Stup702/3d-pos-mashin/case_bottom_b123d.step

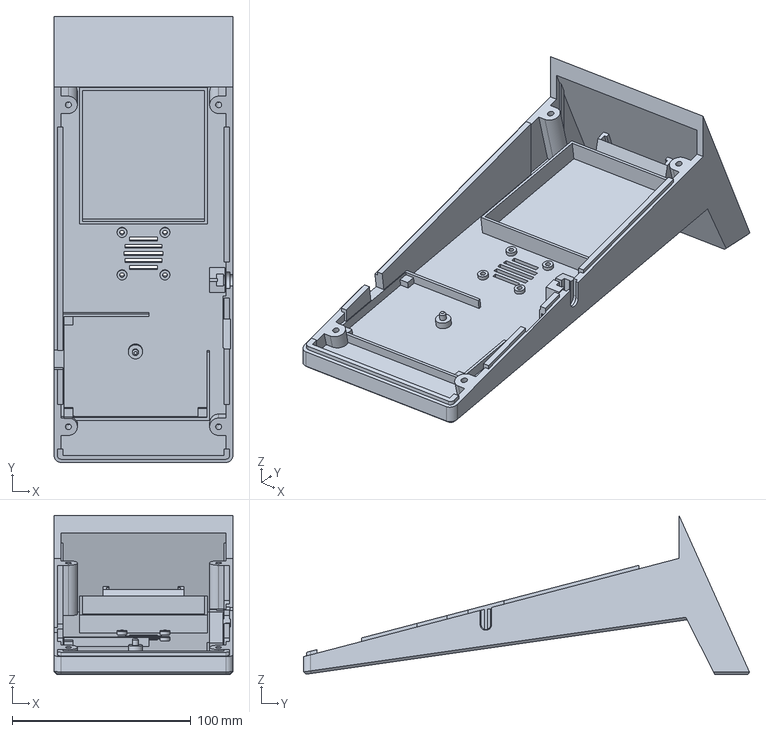
[picture p1: CAD file, 2026-09-17]
case_bottom_b123d.step
100.0 x 249.4 x 89.0 mm
