Stup702/3d-pos-mashin/case_top.step

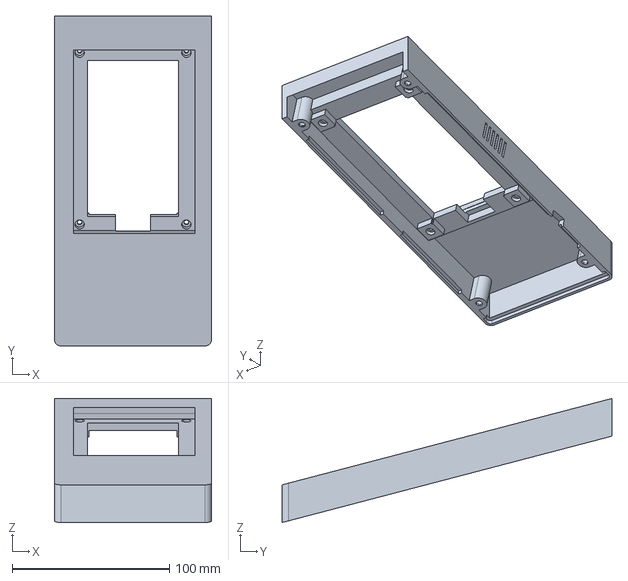
[picture p2: CAD file, 2026-09-17]
case_top.step
100.0 x 210.0 x 79.0 mm
