Stup702/3d-pos-mashin/test_button_plunger.step

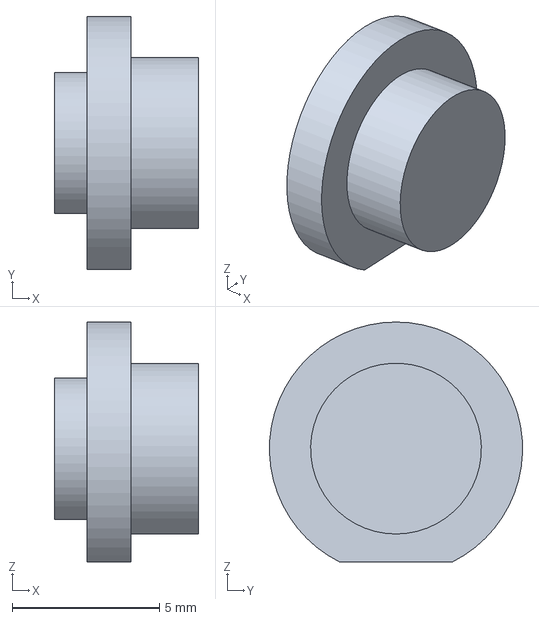
[picture p3: CAD file, 2026-09-17]
test_button_plunger.step
4.90 x 8.59 x 8.15 mm
