Stup702/3d-pos-mashin/test_plate_nfc.step

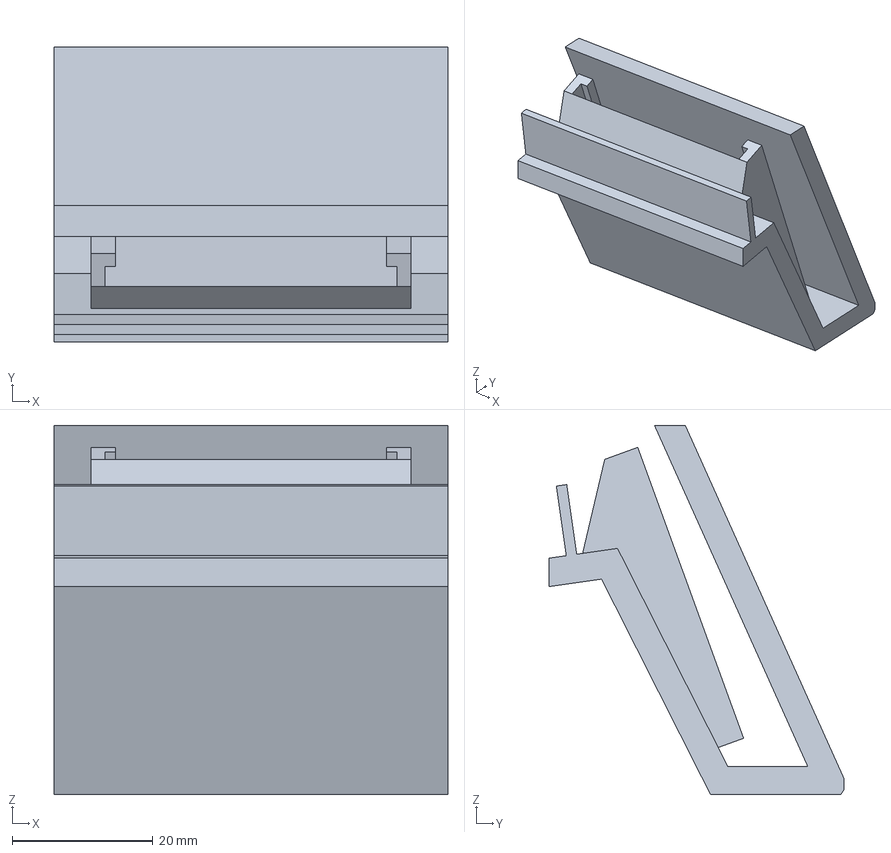
[picture p4: CAD file, 2026-09-17]
test_plate_nfc.step
56.0 x 42.0 x 52.5 mm
