Stup702/3d-pos-mashin/button_keystone.step

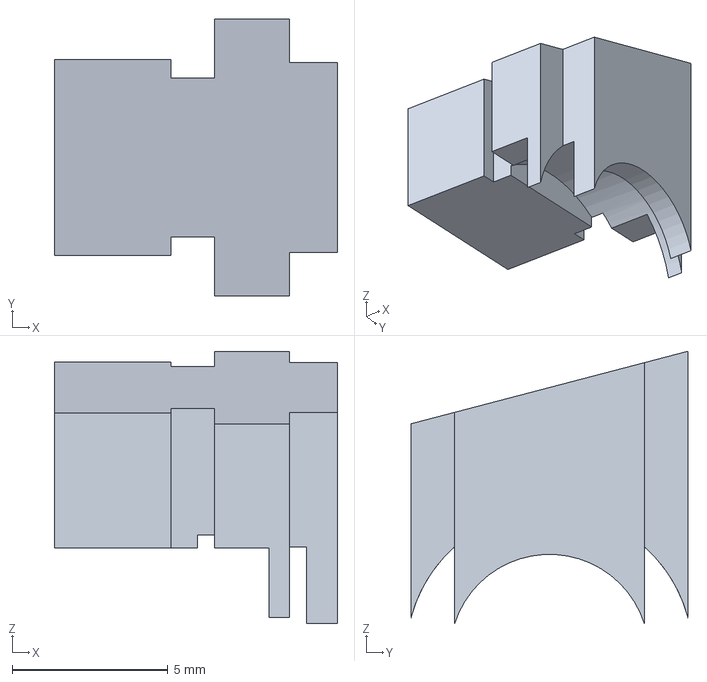
[picture p5: CAD file, 2026-09-17]
button_keystone.step
9.10 x 8.90 x 8.76 mm
