Stup702/3d-pos-mashin/test_plate_acer_vent.step

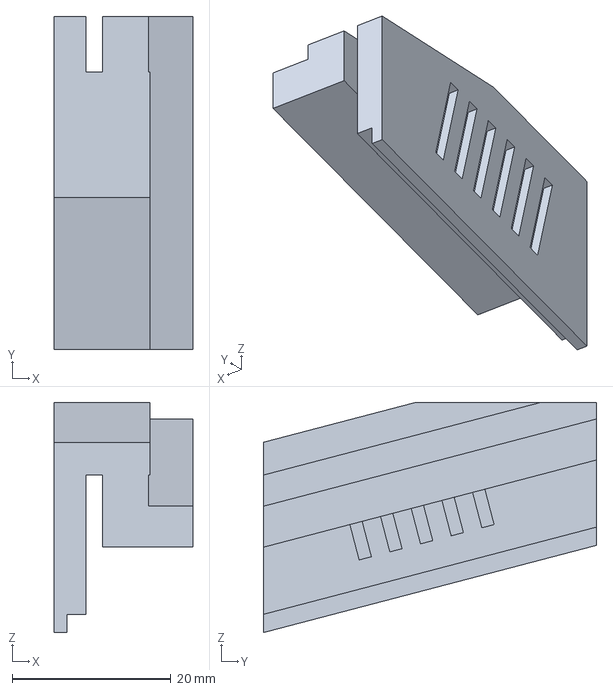
[picture p6: CAD file, 2026-09-17]
test_plate_acer_vent.step
17.5 x 42.0 x 29.0 mm
