Stup702/3d-pos-mashin/test_plate_battery_indicator.step

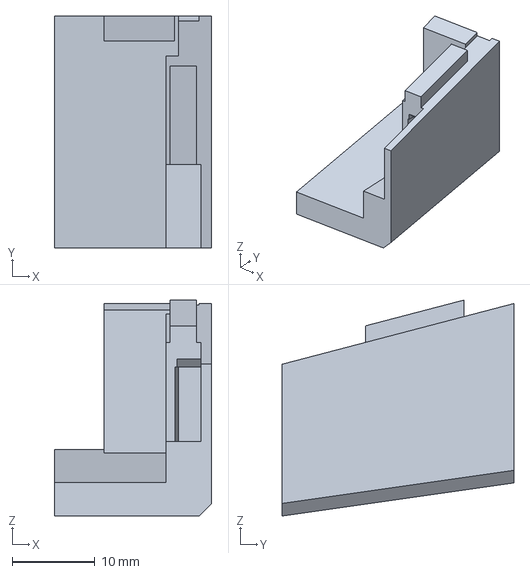
[picture p7: CAD file, 2026-09-17]
test_plate_battery_indicator.step
19.0 x 28.0 x 26.1 mm
