Stup702/3d-pos-mashin/test_plate_heat_insert.step

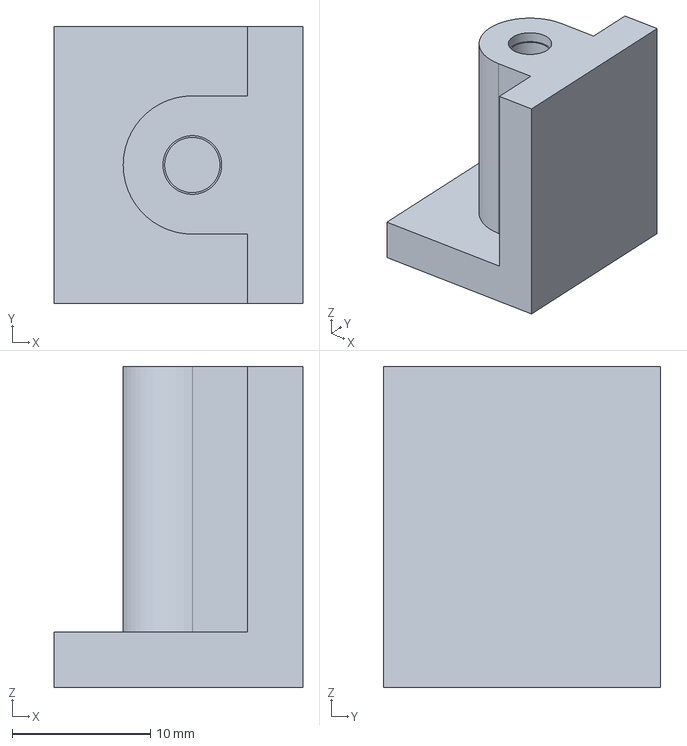
[picture p8: CAD file, 2026-09-17]
test_plate_heat_insert.step
18.0 x 20.0 x 23.2 mm
