Stup702/3d-pos-mashin/test_plate_ups.stl

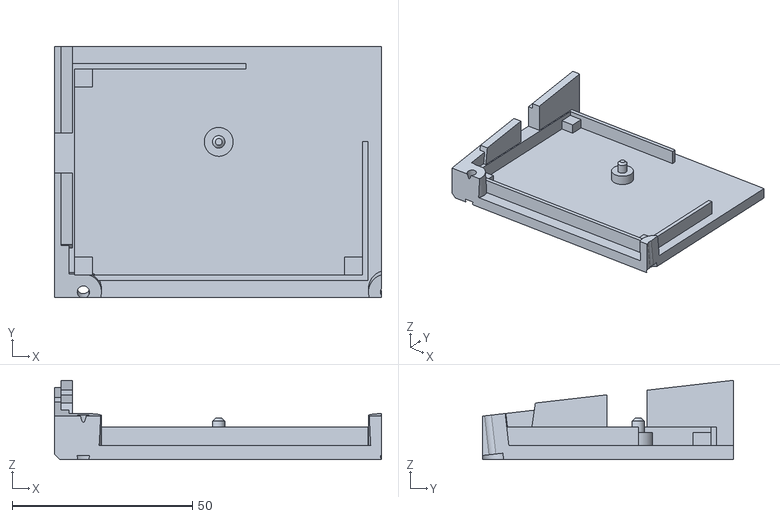
[picture p9: CAD file, 2026-09-16]
test_plate_ups.stl
90.6 x 69.5 x 22.0
