Stup702/3d-pos-mashin/test_plate_screen.stl

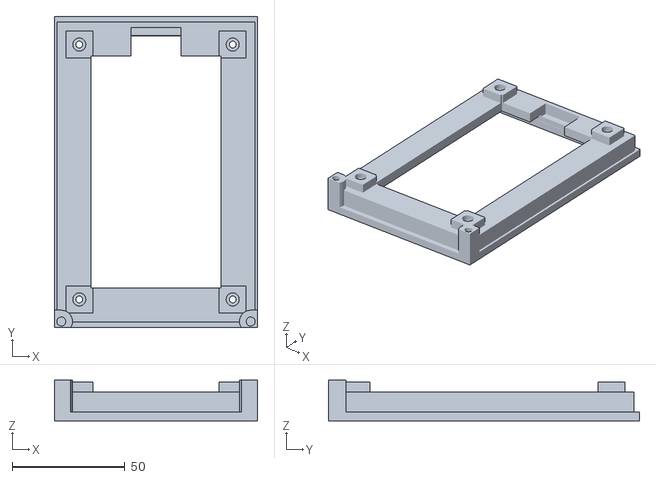
[picture p10: CAD file, 2026-09-16]
test_plate_screen.stl
90.0 x 138.0 x 18.0
