Stup702/3d-pos-mashin/test_plate_battery.stl

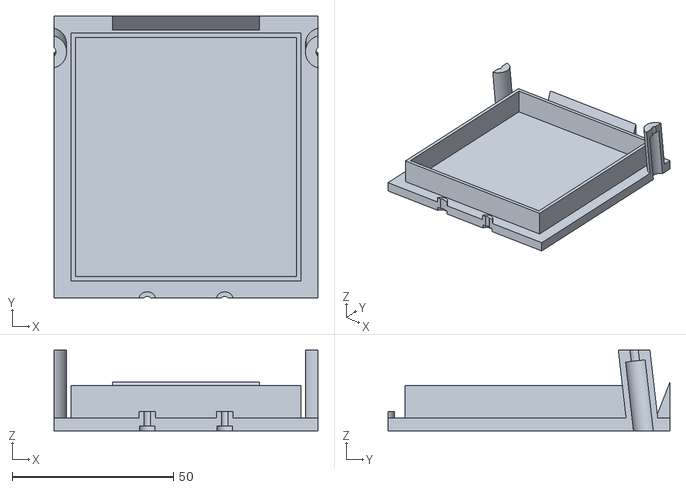
[picture p11: CAD file, 2026-09-16]
test_plate_battery.stl
81.8 x 87.3 x 25.0
