Stup702/3d-pos-mashin/test_plate_fan.stl

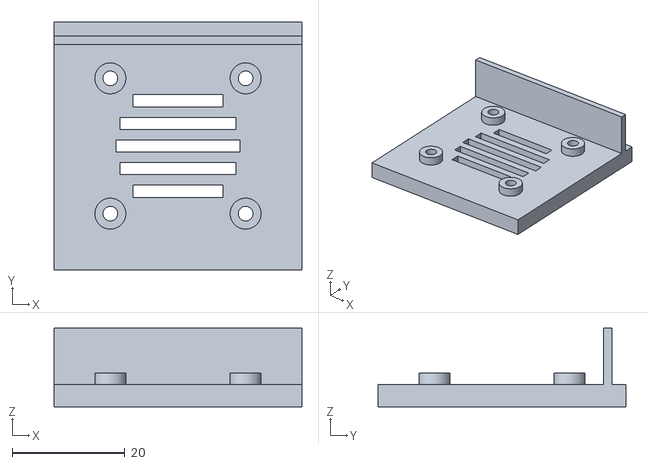
[picture p12: CAD file, 2026-09-16]
test_plate_fan.stl
44.0 x 44.0 x 14.0
