Stup702/3d-pos-mashin/test_plate_button.step

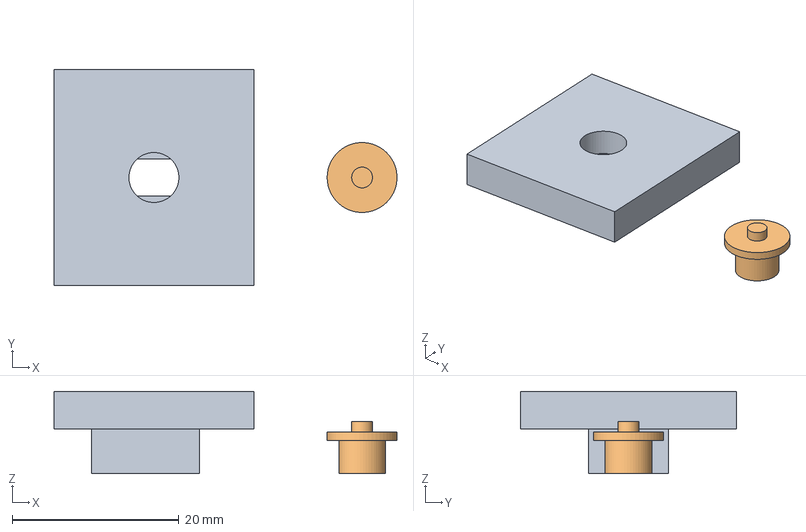
[picture p13: CAD file, 2026-09-15]
test_plate_button.step
41.2 x 26.0 x 9.90 mm
