Stup702/3d-pos-mashin/test_plate_underbelly.step

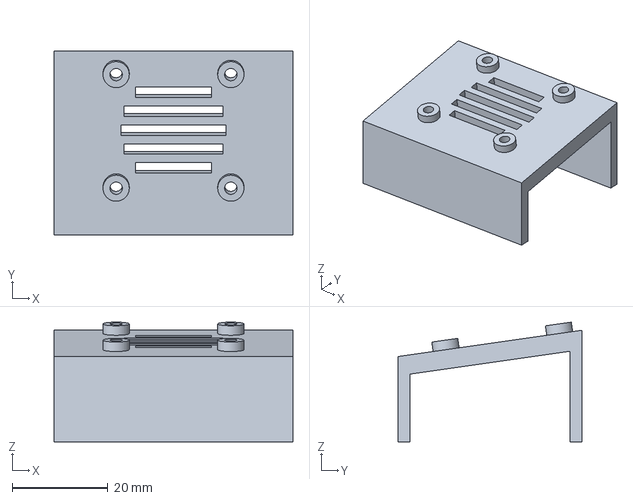
[picture p14: CAD file, 2026-09-15]
test_plate_underbelly.step
50.0 x 38.5 x 25.1 mm
