Stup702/3d-pos-mashin/ups_dummy.stl

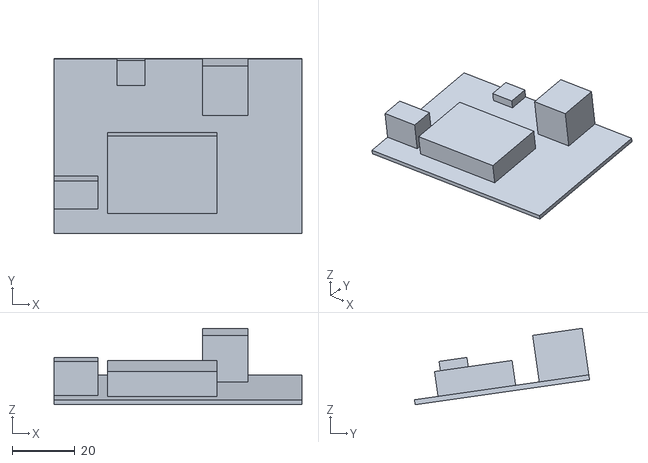
[picture p15: CAD file, 2026-09-07]
ups_dummy.stl
79.1 x 55.9 x 24.4
