Stup702/3d-pos-mashin/screen_dfr0550.stl

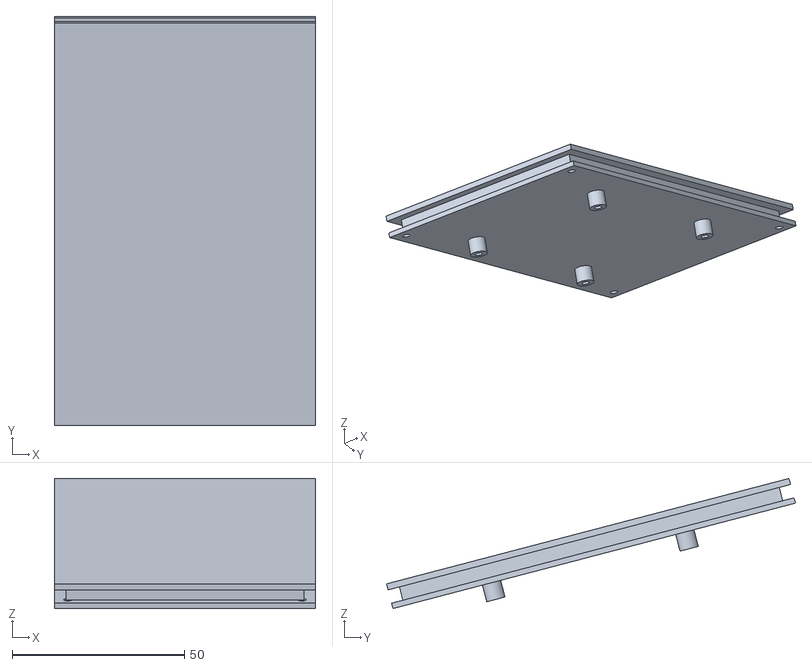
[picture p16: CAD file, 2026-09-07]
screen_dfr0550.stl
75.8 x 118.7 x 37.8
