Stup702/3d-pos-mashin/fan_dummy.stl

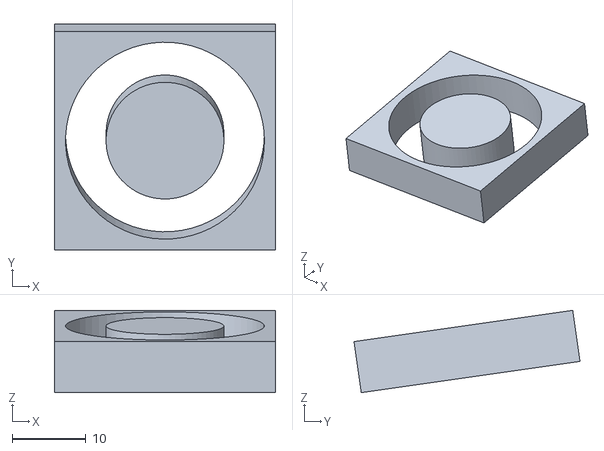
[picture p17: CAD file, 2026-09-07]
fan_dummy.stl
30.0 x 30.7 x 11.2
