Stup702/3d-pos-mashin/rpi4_b.stl

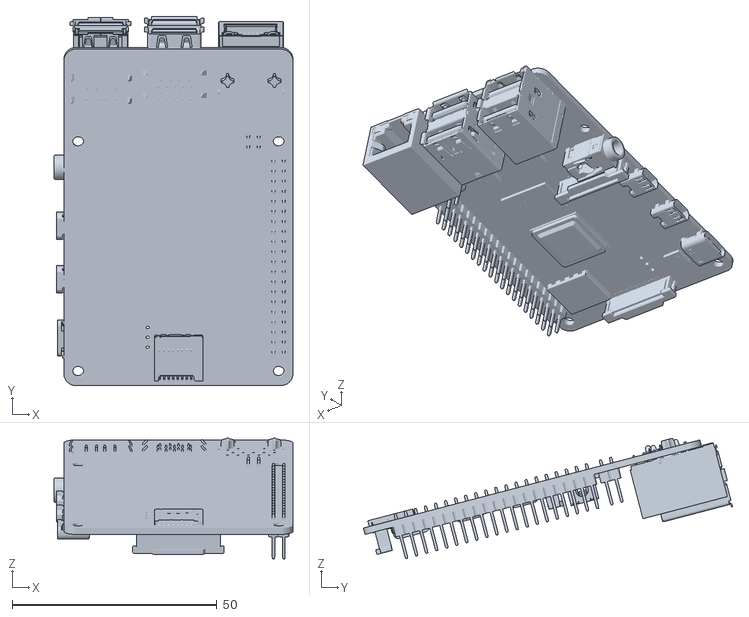
[picture p18: CAD file, 2026-09-07]
rpi4_b.stl
58.4 x 90.2 x 29.5
