Stup702/3d-pos-mashin/battery_dummy.stl

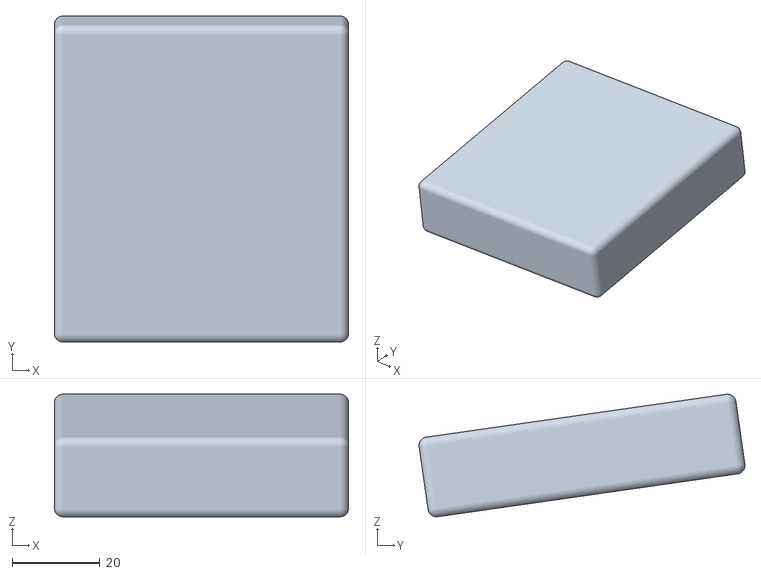
[picture p19: CAD file, 2026-09-05]
battery_dummy.stl
67.2 x 74.5 x 28.0
