Stup702/3d-pos-mashin/part_bottom.scad

include <main.scad>
render_part = 2;
