Stup702/3d-pos-mashin/part_bracket.scad

include <main.scad>
render_part = 3;
