Stup702/3d-pos-mashin/part_top.scad

include <main.scad>
render_part = 1;
