Stup702/3d-pos-mashin/(list of files, cad)

Other CAD files:
case_top_b123d.step
case_bottom.step
button_keystone.stl
case_bottom.stl
case_bottom_b123d.stl
case_top.stl
case_top_b123d.stl
old_stls/pos_terminal_b123d.step
old_stls/pos_terminal_b123d.stl
old_stls/test_button_wall.stl
old_stls/test_logo.stl
old_stls/test_logo_fixed.stl
old_stls/test_mount.stl
old_stls/test_mount_fix.stl
old_stls/test_plate_underbelly.stl
test_button_plunger.stl
test_plate_acer_vent.stl
test_plate_battery_indicator.stl
test_plate_button.stl
test_plate_heat_insert.stl
test_plate_nfc.stl
test_plate_underbelly.stl
