Stup702/3d-pos-mashin/export_test_plates.py

"""
export_test_plates.py
---------------------
Generates small, fast test-print gauge plates by directly slicing the master
CAD parts from enclosure_b123d.py:
1. test_plate_screen.stl   - Screen flush fit, balcony, standoffs, & DSI slot check
2. test_plate_ups.stl      - UPS cradle, 3.5mm boss, corner pads, & DC jack check
3. test_plate_battery.stl  - Battery cradle & rear boss column clearance check

Single source of truth: any geometric update in enclosure_b123d.py automatically
updates these test plates with 100% fidelity.
"""

import os
from build123d import *
from enclosure_b123d import (
    case_top, case_bottom,
    screen_plane, floor_plane,
    ups_cx, ups_cy_local, ups_w, ups_l,
    bat_cx, bat_cy_local, bat_w, bat_l,
    fan_cx, fan_cy_local, fan_size,
    button_plunger, button_keystone
)

OUTPUT_DIR = os.path.dirname(__file__)

def make_screen_test_plate() -> Compound:
    """Direct slice of case_top around the screen pocket and balcony."""
    loc_screen = screen_plane.location
    with BuildPart() as screen_cutter:
        with BuildSketch(screen_plane):
            Rectangle(90.0, 138.0)
        extrude(amount=-18.0)

    screen_cutout = (case_top & screen_cutter.part).moved(loc_screen.inverse())
    # Rotate 180 around X so outer face rests flat at Z=0 and pocket opens upwards
    screen_plate = screen_cutout.rotate(Axis.X, 180)
    bb = screen_plate.bounding_box()
    return screen_plate.moved(Location((-bb.center().X, -bb.center().Y, -bb.min.Z)))

def make_ups_test_plate() -> Compound:
    """Direct slice of case_bottom around the UPS cradle and DC barrel jack wall."""
    loc_floor = floor_plane.location
    with BuildPart() as ups_cutter:
        with BuildSketch(floor_plane.offset(-4.0)):
            with Locations((ups_cx - 1.0, ups_cy_local)):
                Rectangle(ups_w + 14.0, ups_l + 14.0)
        extrude(amount=25.0)

    ups_cutout = (case_bottom & ups_cutter.part).moved(loc_floor.inverse())
    with BuildPart() as floor_trim:
        with BuildSketch(Plane.XY.offset(-4.0)):
            with Locations((ups_cx - 1.0, ups_cy_local)):
                Rectangle(ups_w + 20.0, ups_l + 20.0)
        extrude(amount=50.0)
    ups_plate = (ups_cutout & floor_trim.part)
    bb = ups_plate.bounding_box()
    return ups_plate.moved(Location((-bb.center().X, -bb.center().Y, -bb.min.Z)))

def make_battery_test_plate() -> Compound:
    """Direct slice of case_bottom around the battery cradle and rear pillar clearance."""
    loc_floor = floor_plane.location
    with BuildPart() as bat_cutter:
        with BuildSketch(floor_plane.offset(-4.0)):
            with Locations((bat_cx, bat_cy_local)):
                Rectangle(bat_w + 14.0, bat_l + 14.0)
        extrude(amount=25.0)

    bat_cutout = (case_bottom & bat_cutter.part).moved(loc_floor.inverse())
    with BuildPart() as floor_trim:
        with BuildSketch(Plane.XY.offset(-4.0)):
            with Locations((bat_cx, bat_cy_local)):
                Rectangle(bat_w + 20.0, bat_l + 20.0)
        extrude(amount=50.0)
    bat_plate = (bat_cutout & floor_trim.part)
    bb = bat_plate.bounding_box()
    return bat_plate.moved(Location((-bb.center().X, -bb.center().Y, -bb.min.Z)))

def make_fan_test_plate() -> Compound:
    """Direct slice of case_bottom around the cooling fan mount and air vents."""
    loc_floor = floor_plane.location
    with BuildPart() as fan_cutter:
        with BuildSketch(floor_plane.offset(-4.0)):
            with Locations((fan_cx, fan_cy_local)):
                Rectangle(fan_size + 14.0, fan_size + 14.0)
        extrude(amount=25.0)

    fan_cutout = (case_bottom & fan_cutter.part).moved(loc_floor.inverse())
    with BuildPart() as floor_trim:
        with BuildSketch(Plane.XY.offset(-4.0)):
            with Locations((fan_cx, fan_cy_local)):
                Rectangle(fan_size + 20.0, fan_size + 20.0)
        extrude(amount=50.0)
    fan_plate = (fan_cutout & floor_trim.part)
    bb = fan_plate.bounding_box()
    return fan_plate.moved(Location((-bb.center().X, -bb.center().Y, -bb.min.Z)))

def make_button_test_plate() -> Compound:
    """Direct slice of case_bottom around the right-wall power button cradle and U-slot (includes full floor)."""
    with BuildPart() as btn_cutter:
        with Locations((50.0 - 8.0, 32.0, 25.0)):
            Box(22.0, 22.0, 30.0)
    btn_cutout = case_bottom & btn_cutter.part
    bb = btn_cutout.bounding_box()
    return btn_cutout.moved(Location((-bb.center().X, -bb.center().Y, -bb.min.Z)))

def make_nfc_test_plate() -> Compound:
    """Direct slice of case_bottom around the inclined PN532 NFC socket and rear foot."""
    with BuildPart() as nfc_cutter:
        with Locations((0.0, 158.0, 25.0)):
            Box(56.0, 42.0, 55.0)
    nfc_cutout = case_bottom & nfc_cutter.part
    bb = nfc_cutout.bounding_box()
    return nfc_cutout.moved(Location((-bb.center().X, -bb.center().Y, -bb.min.Z)))

def make_heat_insert_test_plate() -> Compound:
    """Direct slice of case_top around a corner screw boss (heat-set insert test).
    Oriented flat on bed at Z=0 with insert hole pointing straight up for a fast test print."""
    loc_screen = screen_plane.location
    with BuildPart() as insert_cutter:
        with BuildSketch(screen_plane):
            with Locations((42.0, -119.791)):
                Rectangle(20.0, 20.0)
        extrude(amount=-26.0)
    insert_cutout = (case_top & insert_cutter.part).moved(loc_screen.inverse()).rotate(Axis.X, 180)
    bb = insert_cutout.bounding_box()
    return insert_cutout.moved(Location((-bb.center().X, -bb.center().Y, -bb.min.Z)))

def make_battery_indicator_test_plate() -> Compound:
    """Direct slice of case_bottom around the right-wall battery indicator slit and slide-in cradle."""
    with BuildPart() as batt_cutter:
        with Locations((50.0 - 8.0, 14.0, 23.5)):
            Box(22.0, 28.0, 30.0)
    batt_cutout = case_bottom & batt_cutter.part
    bb = batt_cutout.bounding_box()
    return batt_cutout.moved(Location((-bb.center().X, -bb.center().Y, -bb.min.Z)))

def make_acer_vent_test_plate() -> Compound:
    """Direct slice of case_top around the left-wall Acer-style staggered labyrinth air vent."""
    with BuildPart() as vent_cutter:
        with Locations((-45.0, 54.0, 50.0)):
            Box(25.0, 42.0, 32.0)
    vent_cutout = case_top & vent_cutter.part
    bb = vent_cutout.bounding_box()
    return vent_cutout.moved(Location((-bb.center().X, -bb.center().Y, -bb.min.Z)))

if __name__ == "__main__":
    print("Generating rapid test-print gauge plates (Direct Enclosure Slice)...")
    scr_plate = make_screen_test_plate()
    ups_plate = make_ups_test_plate()
    bat_plate = make_battery_test_plate()
    fan_plate = make_fan_test_plate()
    btn_plate = make_button_test_plate()
    nfc_plate = make_nfc_test_plate()
    insert_plate = make_heat_insert_test_plate()
    batt_ind_plate = make_battery_indicator_test_plate()
    acer_vent_plate = make_acer_vent_test_plate()

    export_stl(scr_plate, os.path.join(OUTPUT_DIR, "test_plate_screen.stl"), tolerance=0.05, angular_tolerance=0.2)
    export_stl(ups_plate, os.path.join(OUTPUT_DIR, "test_plate_ups.stl"), tolerance=0.05, angular_tolerance=0.2)
    export_stl(bat_plate, os.path.join(OUTPUT_DIR, "test_plate_battery.stl"), tolerance=0.05, angular_tolerance=0.2)
    export_stl(fan_plate, os.path.join(OUTPUT_DIR, "test_plate_fan.stl"), tolerance=0.05, angular_tolerance=0.2)
    export_stl(btn_plate, os.path.join(OUTPUT_DIR, "test_plate_button.stl"), tolerance=0.05, angular_tolerance=0.2)
    export_stl(nfc_plate, os.path.join(OUTPUT_DIR, "test_plate_nfc.stl"), tolerance=0.05, angular_tolerance=0.2)
    export_stl(insert_plate, os.path.join(OUTPUT_DIR, "test_plate_heat_insert.stl"), tolerance=0.02, angular_tolerance=0.1)
    export_stl(batt_ind_plate, os.path.join(OUTPUT_DIR, "test_plate_battery_indicator.stl"), tolerance=0.02, angular_tolerance=0.1)
    export_stl(acer_vent_plate, os.path.join(OUTPUT_DIR, "test_plate_acer_vent.stl"), tolerance=0.02, angular_tolerance=0.1)
    export_step(nfc_plate, os.path.join(OUTPUT_DIR, "test_plate_nfc.step"))
    export_step(insert_plate, os.path.join(OUTPUT_DIR, "test_plate_heat_insert.step"))
    export_step(batt_ind_plate, os.path.join(OUTPUT_DIR, "test_plate_battery_indicator.step"))
    export_step(acer_vent_plate, os.path.join(OUTPUT_DIR, "test_plate_acer_vent.step"))
    export_stl(button_plunger, os.path.join(OUTPUT_DIR, "test_button_plunger.stl"), tolerance=0.02, angular_tolerance=0.1)
    export_stl(button_keystone, os.path.join(OUTPUT_DIR, "test_button_keystone.stl"), tolerance=0.02, angular_tolerance=0.1)

    print("✓ Successfully exported direct-cut test plates:")
    print("  1. test_plate_screen.stl")
    print("  2. test_plate_ups.stl")
    print("  3. test_plate_battery.stl")
    print("  4. test_plate_fan.stl")
    print("  5. test_plate_button.stl")
    print("  6. test_plate_nfc.stl")
    print("  7. test_plate_heat_insert.stl")
    print("  8. test_plate_battery_indicator.stl")
    print("  9. test_plate_acer_vent.stl")
    print(" 10. test_button_plunger.stl")
    print(" 11. test_button_keystone.stl")
