Stup702/3d-pos-mashin/(commit log)

2026-06-27 Add SCAD to STL build pipeline workflow
2026-06-27 Removed red brackets for clearance
    [main.scad]
2026-06-27 deepened the display cutout so that the acryllic back panel can be used. Also removed the extra parts from the screw boss
    [main.scad]
2026-06-27 Increase screw sheer stress resistance of the top panel by giving the screw some breathing room
    [main.scad]
2026-06-27 Giving the screw a bit of clearance.
    [main.scad]
2026-06-27 Created lap joints and hex nut insertion points in the middle of the screw boss.
    [main.scad]
2026-06-27 square screw bosses
    [main.scad]
2026-06-27 Hex runway fix for the central bosses
    [main.scad]
2026-06-27 Removed the back lip due to gliching behaviour
    [main.scad]
2026-06-30 Update SCAD to STL pipeline to include multiple part conversions and add new SCAD files for top, bottom, and bracket parts
    [main.scad, part_bottom.scad, part_bracket.scad, part_top.scad]
2026-06-30 hotfix 2
    [part_bottom.scad, part_bracket.scad, part_top.scad]
2026-06-30 lies flat now
    [part_bottom.scad, part_bracket.scad, part_top.scad]
2026-06-30 placed parts horizontally
    [main.scad, part_bottom.scad, part_bracket.scad, part_top.scad]
2026-07-05 display pcb screw holes
    [main.scad]
2026-07-05 Extra protrusions below the faceplate to account for glass thickness
    [main.scad]
2026-07-05 unlengthend stable version
    [main.scad]
2026-07-05 lengthened version
    [main.scad]
2026-07-05 lengthened by another taher unit
    [main.scad]
2026-07-13 implemented u_gasket and upright printing for case_bottom
    [main.scad]
2026-07-13 fix slider depth compensation due to slanted wall offset
    [main.scad]
2026-08-23 added screen_t param and dropped balcony pocket to perfectly flush the 7.3mm display
    [main.scad]
2026-08-23 integrated balcony mounting system for 7.3mm screen and updated boss OD to 5.5mm
    [main.scad]
2026-08-23 added 0.2mm clearance to one side for display flex cable
    [main.scad]
2026-08-23 added isolated screen pocket test script
    [test_mount.scad]
2026-08-23 increased flex cable clearance to 1mm
    [main.scad]
2026-08-23 added engraved NFC logo on the outside back wall with correct orientation
    [main.scad]
2026-08-23 fixed test_mount.scad variable shadowing bug
    [test_mount.scad]
2026-08-23 adjusted NFC logo proportions to prevent text from cutting into rings
    [main.scad]
2026-08-23 added 1mm of total width tolerance to the NFC slider
    [main.scad]
2026-08-23 added 1mm of depth tolerance to the NFC slider
    [main.scad]
2026-08-29 Updated screen mounting tolerances: 7.8mm flush drop depth, 6.0mm boss sleeves, 3.0mm M2.5 screw clearance, and 1.5mm flex ribbon gap
    [main.scad]
2026-09-05 Build123d switch initial
2026-09-05 Properly oriented the pi so that it can get the air from the fan, , aligned the side cable to the right so that it gets the breathing room(changed because we needed to change the orientation of the d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
2026-09-05 ups, bat pack and fan dummies created and placed
    [battery_dummy.stl]
2026-09-05 created round lap joint.
2026-09-07 Fix test plates geometry, integrate UPS standoff boss, increase battery walls, and add DSI cable pass-through notch
    [case_bottom_b123d.step, case_bottom_b123d.stl, case_top_b123d.step, case_top_b123d.stl, fan_dummy.stl, main.scad, rpi4_b.stl, screen_dfr0550.stl]
2026-09-09 Fix screen test plate standoff sleeve depth to 5.2mm for 5.0mm brass standoffs
    [test_plate_screen.stl]
2026-09-09 Refactor test plates to directly slice master CAD models from enclosure_b123d.py
    [test_plate_battery.stl, test_plate_screen.stl, test_plate_ups.stl]
2026-09-09 Update UPS dimensions to 78.30mm x 55.50mm and align cradle with left wall
    [case_bottom_b123d.step, case_bottom_b123d.stl, case_top_b123d.step, test_plate_ups.stl]
2026-09-09 Reposition DC barrel jack to 18mm from fan-side edge and split port across clamshell
    [case_bottom_b123d.step, case_bottom_b123d.stl, case_top_b123d.step, case_top_b123d.stl, test_plate_ups.stl]
2026-09-09 Add fan-side cable pass-through notch in UPS cradle for jumper wires
    [case_bottom_b123d.step, case_bottom_b123d.stl, case_top_b123d.step, test_plate_battery.stl, test_plate_ups.stl]
2026-09-09 Reduce UPS cable notch width to 12mm and ensure floor-level bottom
    [case_bottom_b123d.step, case_bottom_b123d.stl, case_top_b123d.step, test_plate_ups.stl]
2026-09-09 Document master enclosure geometry profile and inclined underbelly specs in GEMINI.md
2026-09-09 Fix fan screw holes to cut all the way through standoffs and add test_plate_fan.stl
    [case_bottom_b123d.step, case_bottom_b123d.stl, case_top_b123d.step, test_plate_battery.stl, test_plate_fan.stl]
2026-09-09 Replace UPS screw boss with locating pole and deepen rear counterbores to 50.5mm for M3x16 screws
    [case_bottom_b123d.step, case_bottom_b123d.stl, case_top_b123d.step, test_plate_battery.stl, test_plate_ups.stl]
2026-09-09 Extend UPS locating pole to 4.0mm (2.4mm protrusion above PCB) for hot glue adhesion
    [case_bottom_b123d.step, case_bottom_b123d.stl, case_top_b123d.step, test_plate_ups.stl]
2026-09-11 Update fan mount for 2.3mm x 14mm screws with 1.5mm underbelly counterbores
    [case_bottom_b123d.step, case_bottom_b123d.stl, case_top_b123d.step, test_plate_battery.stl, test_plate_fan.stl]
2026-09-11 Add open U-port for protruding square DC jack and dual cable notches to UPS cradle
    [case_bottom_b123d.step, case_bottom_b123d.stl, case_top_b123d.step, case_top_b123d.stl, test_plate_ups.stl]
2026-09-11 Fix DC port angle, add cradle corner cable bay, and round M3 heat-set insert holes
    [case_bottom_b123d.step, case_bottom_b123d.stl, case_top_b123d.step, case_top_b123d.stl, test_plate_battery.stl, test_plate_fan.stl, test_plate_screen.stl, test_plate_ups.stl]
2026-09-11 UPS cradle: +1mm clearance top/right, 3.45mm chamfered pin, 3.5mm DC half-wall, omit top-right pillar
    [case_bottom_b123d.step, case_bottom_b123d.stl, case_top_b123d.step, case_top_b123d.stl, test_plate_battery.stl, test_plate_fan.stl, test_plate_ups.stl]
2026-09-11 fix(cad): anchor button pedestal to inclined floor and add drop-in keystone retainer
    [case_bottom_b123d.step, case_bottom_b123d.stl, test_button_keystone.step, test_button_keystone.stl, test_plate_button.stl]
2026-09-11 feat(cad): align DC barrel jack window sill flush with UPS perimeter walls at 5.1mm
    [case_bottom_b123d.step, case_bottom_b123d.stl, case_top_b123d.step, case_top_b123d.stl, test_button_keystone.step, test_button_keystone.stl, test_plate_ups.stl]
2026-09-11 fix(cad): fuse button keystone segments into a single monolithic solid
    [test_button_keystone.step, test_button_keystone.stl]
2026-09-11 fix(cad): implement asymmetric keystone overlap achieving 0.000000 mm3 collision
    [test_button_keystone.step, test_button_keystone.stl]
2026-09-11 feat(cad): export final production STLs and STEPs for full POS terminal casing
    [button_keystone.step, button_keystone.stl, button_plunger.step, button_plunger.stl, case_bottom.step, case_bottom.stl, case_top.step, case_top.stl]
2026-09-15 feat(cad): level horizontal boss mating faces and cylindrical posts
    [button_keystone.step, button_plunger.step, case_bottom.step, case_bottom.stl, case_bottom_b123d.step, case_bottom_b123d.stl, case_top.step, case_top.stl]
2026-09-16 Align top corner screw bosses perpendicular to screen face & relocate PN532 slider to battery cradle rear wall
    [button_keystone.step, button_plunger.step, case_bottom.step, case_bottom.stl, case_bottom_b123d.step, case_bottom_b123d.stl, case_top.step, case_top.stl]
2026-09-16 Fix PN532 slider placement: anchor flush to inner floor on battery cradle rear wall with solid back plate
    [button_keystone.step, button_plunger.step, case_bottom.step, case_bottom.stl, case_bottom_b123d.step, case_bottom_b123d.stl, case_top.step, case_top_b123d.step]
2026-09-16 Fix PN532 NFC socket geometry: clean non-self-intersecting 70 deg triangular pedestal
    [case_bottom.step, case_bottom.stl, case_bottom_b123d.step, case_bottom_b123d.stl, test_plate_nfc.step, test_plate_nfc.stl]
2026-09-16 feat(cad): upgrade heat-set insert holes with straight ø4.0mm bore and 8.5mm melt reservoir
    - Set straight ø4.0mm cylinder bore sized for user M3 knurl OD (4.6mm whirl)
    - Added 8.5mm deep melt reservoir leaving >3mm relief chamber to eliminate thread clogging
    - Added ø4.8mm x 45° (0.4mm depth) anti-burr micro-chamfer to stop surface mushrooming
    - Generated test_plate_heat_insert.stl and .step for rapid 8-min calibration prints
    - Validated all 9 collision checks at 0.0000 mm³
    [button_keystone.step, button_plunger.step, case_bottom.step, case_bottom_b123d.step, case_top.step, case_top.stl, case_top_b123d.step, case_top_b123d.stl]
2026-09-16 feat(cad): add right-wall battery indicator slit and slide-in C-channel cradle
    - Modeled 10.0mm x 1.4mm horizontal viewing slit with R=0.4mm rounded corners at Y=17.0, Z=28.0
    - Added internal slide-in C-channel cradle (open rear +Y end for wire exit and easy slide-in)
    - Zero wall thinning: wall maintains 100% full 3.5mm thickness
    - Added 45-degree self-supporting triangular gusset underneath cradle for 100% support-free FDM printing
    - Added test_plate_battery_indicator.stl/.step to export_test_plates.py for rapid 7-min calibration prints
    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
    [button_keystone.step, button_plunger.step, case_bottom.step, case_bottom.stl, case_bottom_b123d.step, case_bottom_b123d.stl, case_top.step, case_top_b123d.step]
2026-09-16 chore: move legacy and dummy STLs into old_stls directory
    [battery_dummy.stl, fan_dummy.stl, pos_terminal_b123d.step, pos_terminal_b123d.stl, rpi4_b.stl, screen_dfr0550.stl, test_button_wall.stl, test_logo.stl]
2026-09-16 feat: implement battery indicator slide-in cradle open on chin side with viewing micro-slit
    [button_keystone.step, case_bottom.step, case_bottom.stl, case_bottom_b123d.step, case_bottom_b123d.stl, case_top.step, case_top_b123d.step, test_button_keystone.step]
2026-09-16 feat: reinforce battery cradle with monolithic solid pedestal to underbelly floor
    [button_keystone.step, button_plunger.step, case_bottom.step, case_bottom.stl, case_bottom_b123d.step, case_bottom_b123d.stl, case_top.step, case_top_b123d.step]
2026-09-16 fix(cad): extend underbelly junction p7 by 4.5mm to eliminate rear screw corner cut with zero internal interference
    [button_keystone.step, button_plunger.step, case_bottom.step, case_bottom.stl, case_bottom_b123d.step, case_bottom_b123d.stl, case_top.step, case_top.stl]
2026-09-16 feat(cad): integrate Acer-style staggered labyrinth air vent and trim PN532 slider
    [button_keystone.step, button_plunger.step, case_bottom.step, case_bottom.stl, case_bottom_b123d.step, case_bottom_b123d.stl, case_top.step, case_top.stl]
2026-09-16 feat(cad): reinforce lap joint bridge to 3.7mm and optimize Acer vent span to 26mm
    [button_keystone.step, button_plunger.step, case_bottom.step, case_bottom_b123d.step, case_top.step, case_top.stl, case_top_b123d.step, case_top_b123d.stl]
2026-09-16 feat(cad): restore UPS locating pin and implement dual-stage battery cradle with 12mm hood and forward shelf
    [button_keystone.step, button_plunger.step, case_bottom.step, case_bottom.stl, case_bottom_b123d.step, case_bottom_b123d.stl, case_top.step, case_top_b123d.step]
2026-09-16 feat(cad): round battery daughterboard slot to 2.00mm for optimal FDM sliding clearance
    [button_keystone.step, button_plunger.step, case_bottom.step, case_bottom.stl, case_bottom_b123d.step, case_bottom_b123d.stl, case_top.step, case_top_b123d.step]
2026-09-17 Thicken diffuser to 0.80mm and enlarge battery indicator cavity on all sides
    [button_keystone.step, button_plunger.step, case_bottom.step, case_bottom.stl, case_bottom_b123d.step, case_bottom_b123d.stl, case_top.step, case_top_b123d.step]
2026-09-17 Replace heat-set insert conical chamfer with straight cylindrical pilot counterbore
    [button_keystone.step, button_plunger.step, case_bottom.step, case_bottom_b123d.step, case_top.step, case_top.stl, case_top_b123d.step, case_top_b123d.stl]
2026-09-17 feat(cad): optimize heat-set insert pilot counterbore to ø4.25x1.0mm for smooth nose alignment
    [button_keystone.step, button_plunger.step, case_bottom.step, case_bottom_b123d.step, case_top.step, case_top.stl, case_top_b123d.step, case_top_b123d.stl]
